DSSCircuits/GeogramONE/EAGLE Files/Geogram ONE.brd

## EAGLE design EAGLE Files/Geogram ONE.brd (2012-09-10)

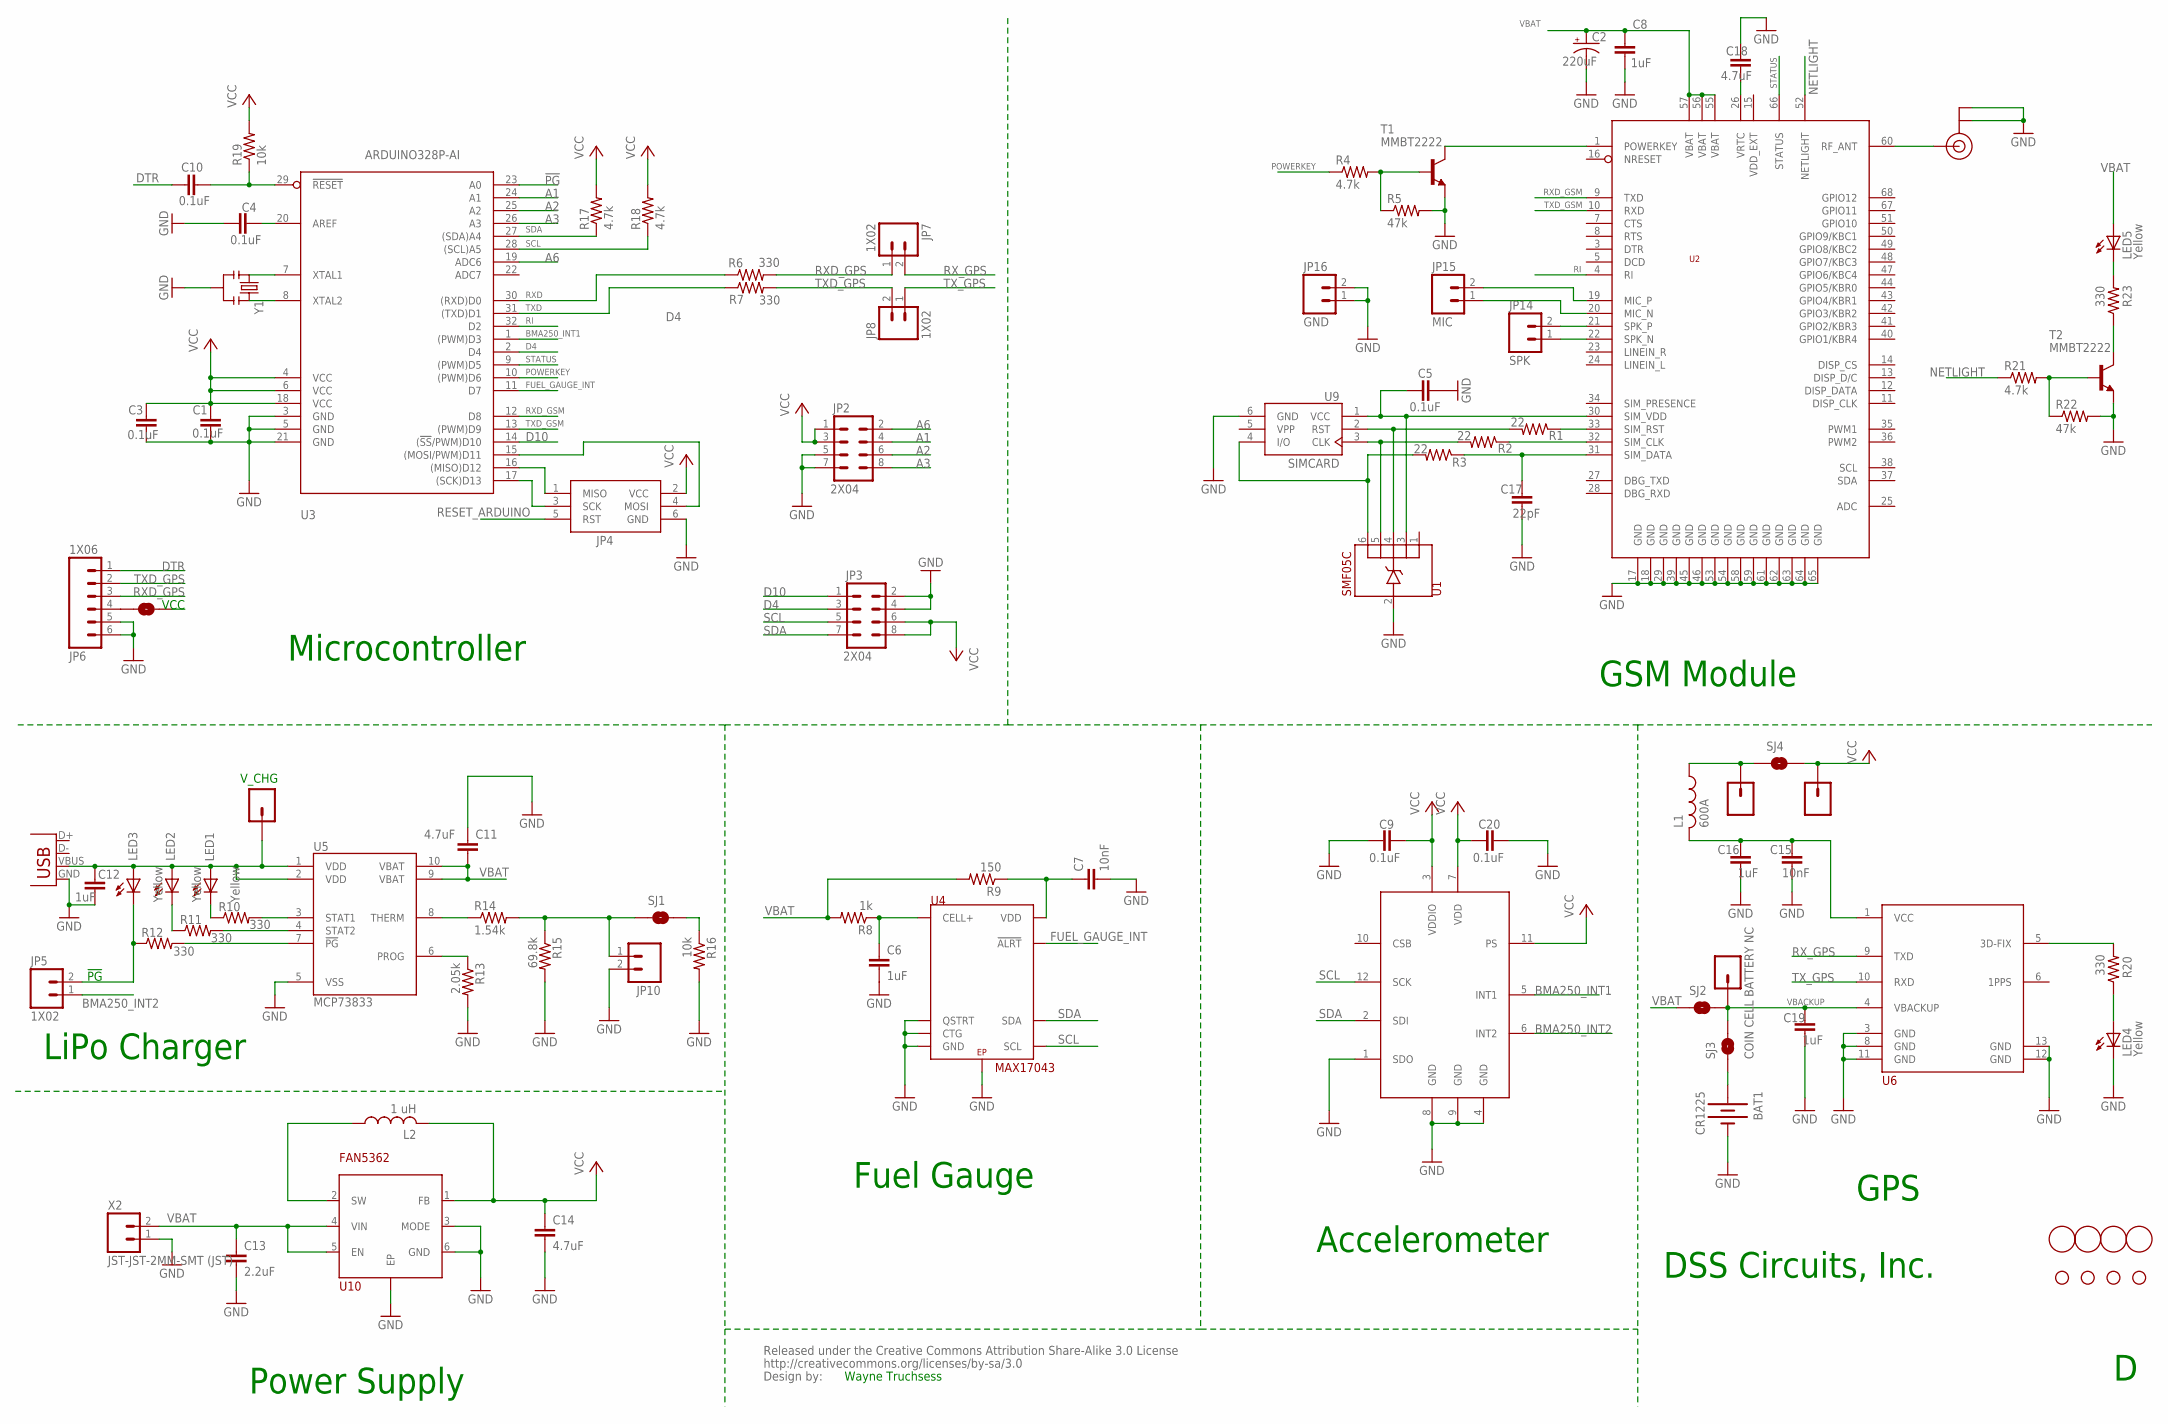
[picture p1: schematic Geogram ONE.sch]

Parts:
BAT1: CR1225; BATTCON_12MM; MOUSER# 534-3000TR; DIGIKEY# 3000KTR-ND
C1, C3, C4, C5, C9, C10, C20: 0.1uF; C0603; MOUSER# 80-C0603C104K8R; DIGIKEY# 399-1095-2-ND
C2: 220uF; D/7343-31R; MOUSER# 80-T520D227M010; DIGIKEY# 399-4045-2-ND
C6, C8, C12, C16, C19: 1uF; C0603; MOUSER# 810-C1608X5R1A105K; DIGIKEY# 445-1321-2-ND
C7, C15: 10nF; C0603; MOUSER# 77-VJ0603Y103KXQCBC
C11, C14, C18: 4.7uF; C0603; MOUSER# 80-C0603C475K9P; DIGIKEY# 399-3482-2-ND
C13: 2.2uF; C0603; MOUSER# 80-C0603C225K9P; DIGIKEY# 399-3362-2-ND
C17: 22pF; C0603; MOUSER# 77-VJ0603A220KXJPBC
FIDUCIAL1, FIDUCIAL2, FIDUCIAL3, FIDUCIAL4: FIDUCIAL; FIDUCIAL_1MM
JP2, JP3: 2X04; 2X4
JP4: AVRISP-6; AVRISP
JP5, JP7, JP8: 1X02; 1X02_NO_SILK
JP6: 1X06
JP9: V_CHG; 1X01
JP10: EXT THERMISTER; 1X02_NO_SILK
JP11: EXT_BAT; 1X01
JP12, JP13: EXT GPS POWER JPR; 1X01
JP14: SPK; 1X02_NO_SILK
JP15: MIC; 1X02_NO_SILK
JP16: GND; 1X02_NO_SILK
L1: 600A; L2012C; MOUSER# 810-MMZ2012R601A
L2: 1 uH; L2012C; MOUSER# 81-LQM21PN1R0MC0D; DIGIKEY# 490-4992-2-ND
LED1, LED2, LED3, LED4, LED5: Yellow; CHIP-LED0603; MOUSER# 720-LYQ971H1K136; DIGIKEY# 475-2557-2-ND
LICENSE: CREATIVE_COMMONS
R1, R2, R3: 22; R0603; MOUSER# 667-ERJ-3EKF22R0V; DIGIKEY# P22.0HTR-ND
R4, R17, R18, R21: 4.7k; R0603; MOUSER# 667-ERJ-3EKF4701V; DIGIKEY# P4.70KHTR-ND
R5, R22: 47k; R0603; MOUSER# 667-ERJ-3EKF4702V; DIGIKEY# P47.0KHTR-ND
R6, R7, R10, R11, R12, R20, R23: 330; R0603; MOUSER# 667-ERJ-3EKF3300V; DIGIKEY# P330HTR-ND
R8: 1k; R0603; MOUSER# 667-ERJ-3EKF1001V; DIGIKEY# P1.00KHTR-ND
R9: 150; R0603; MOUSER# 667-ERJ-3EKF1500V; DIGIKEY# P150HTR-ND
R13: 2.05k; R0603; MOUSER# 667-ERJ-3EKF2051V; DIGIKEY# P2.05KHTR-ND
R14: 1.54k; R0603; MOUSER# 71-CRCW0603-1.54K-E3; DIGIKEY# 541-1.54KHTR-ND
R15: 69.8k; R0603; MOUSER# 667-ERJ-3EKF6982V; DIGIKEY# P69.8KHTR-ND
R16, R19: 10k; R0603; MOUSER# 667-ERJ-3EKF1002V; DIGIKEY# P10.0KHTR-ND
SJ1: EXT THERMISTER NC; SJ_2S-TRACE
SJ2: LIPO BATTERY NO; SJ_2S-NO
SJ3: COIN CELL BATTERY NC; SJ_2S-TRACE
SJ4: EXT GPS POWER NC; SJ_2S-TRACE
SJ5: EXT VCC NO; SJ_2S-NO
STANDOFF1, STANDOFF2, STANDOFF3, STANDOFF4: STAND-OFF
T1, T2: MMBT2222; SOT23-BEC; MOUSER# 512-MMBT2222A; DIGIKEY# MMBT2222AFSTR-ND
U1: SMF05C; SC70-6L; DIGIKEY# SMF05CTR-ND
U2: SIM900
U3: ARDUINO328P-AI; TQFP32-08; MOUSER# 556-ATMEGA328P-AU; DIGIKEY# ATMEGA328P-AU-ND
U4: MAX17043; TDFN8; MOUSER# 700-MAX17043G+T; DIGIKEY# MAX17043G+T-ND
U5: MCP73833; MSOP-10; MOUSER# 579-MCP73833-FCI/UN; DIGIKEY# MCP73833-FCI/UN-ND
U6: PA6C
U7: BMA250; 12LGA_VGG3-D; DIGIKEY# 828-1023-6-ND
U8: U.FL; MOUSER# 960-RECE20279001E01; DIGIKEY# 931-1107-2-ND
U9: SIMCARD; MOUSER# 649-7111S2015X02LF; DIGIKEY# 609-1401-2-ND
U10: FAN5362; UMLP; MOUSER# 512-FAN5362UMP33X; DIGIKEY# FAN5362UMP33X-ND
X1: USBSMD; USB-MINIB; DIGIKEY# ED2992TR-ND
X2: JST-JST-2MM-SMT (JST); JST; DIGIKEY# 455-1749-2-ND
Y1: 8 MHz; RESONATOR-SMD; MOUSER# 81-CSTCE8M00G52Z-R0

Connections:
!PG: JP5.2, LED3.C, R12.1, U3.23 (A0)
A1: JP2.4, U3.24 (A1)
A2: JP2.6, U3.25 (A2)
A3: JP2.8, U3.26 (A3)
A6: JP2.2, U3.19 (ADC6)
AREF: C4.2, U3.20 (AREF)
BMA250_INT1: U3.1 ((PWM)D3), U7.5 (INT1)
BMA250_INT2: JP5.1, U7.6 (INT2)
D4: JP3.3, U3.2 (D4)
D10: JP3.1, U3.14 ((!SS!/PWM)D10)
DTR: C10.1, JP6.1
FUEL_GAUGE_INT: U3.11 (D7), U4.!ALRT
GND: BAT1.GND (-), C1.2, C2.-, C3.2, C4.1, C5.2, C6.2, C7.2, C8.2, C9.2, C11.1, C12.2, C13.2, C14.2, C15.1, C16.1, C17.1, C18.1, C19.1, C20.1, JP2.5, JP2.7, JP3.2, JP3.4, JP4.6 (GND), JP6.5, JP6.6, JP10.2, JP16.1, JP16.2, LED4.C, R5.2, R13.2, R15.2, R16.2, R22.2, T1.E, T2.E, U1.2, U2.17 (GND), U2.18 (GND), U2.29 (GND), U2.39 (GND), U2.45 (GND), U2.46 (GND), U2.53 (GND), U2.54 (GND), U2.58 (GND), U2.59 (GND), U2.61 (GND), U2.62 (GND), U2.63 (GND), U2.64 (GND), U2.65 (GND), U3.3 (GND), U3.5 (GND), U3.21 (GND), U4.CTG, U4.EP, U4.GND, U4.QSTRT, U5.5 (VSS), U6.3 (GND), U6.8 (GND), U6.11 (GND), U6.12 (GND), U6.13 (GND), U7.1 (SDO), U7.4 (GND), U7.8 (GND), U7.9 (GND), U8.P$1 (GND), U8.P$2 (GND), U9.6 (GND), U10.3 (MODE), U10.6 (GND), U10.7 (EP), X1.GND, X2.1, Y1.2
MIC_N: JP15.1, U2.20 (MIC_N)
MIC_P: JP15.2, U2.19 (MIC_P)
MISO: JP4.1 (MISO), U3.16 ((MISO)D12)
MOSI: JP4.4 (MOSI), U3.15 ((MOSI/PWM)D11)
unnamed: C18.2, U2.26 (VRTC)
unnamed: R2.1, U2.32 (SIM_CLK)
unnamed: R20.2, U6.5 (3D-FIX)
unnamed: C6.1, R8.1, U4.CELL+
unnamed: R1.1, U2.33 (SIM_RST)
unnamed: C17.2, R3.1, U2.31 (SIM_DATA)
unnamed: R2.2, U1.5, U9.3 (CLK)
unnamed: R1.2, U1.4, U9.2 (RST)
unnamed: R3.2, U1.6, U9.4 (I/O)
unnamed: LED4.A, R20.1
unnamed: U2.60 (RF_ANT), U8.P$3 (SIGNAL)
unnamed: T1.C, U2.1 (POWERKEY)
unnamed: R4.2, R5.1, T1.B
unnamed: BAT1.PWR@2 (+), SJ3.1
unnamed: R21.2, R22.1, T2.B
unnamed: R23.1, T2.C
unnamed: JP6.4, SJ5.2
unnamed: C7.1, R9.1, U4.VDD
unnamed: LED1.C, R10.1
unnamed: LED2.C, R11.1
unnamed: JP12.1, L1.1, SJ4.1, SJ5.1
unnamed: R13.1, U5.6 (PROG)
unnamed: R14.1, U5.8 (THERM)
unnamed: LED5.C, R23.2
unnamed: JP10.1, R14.2, R15.1, SJ1.1
unnamed: L2.1, U10.2 (SW)
unnamed: R16.1, SJ1.2
NETLIGHT: R21.1, U2.52 (NETLIGHT)
PG: R12.2, U5.7 (!PG)
POWERKEY: R4.1, U3.10 ((PWM)D6)
RESET_ARDUINO: C10.2, JP4.5 (RST), R19.1, U3.29 (!RESET)
RI: U2.4 (RI), U3.32 (D2)
RXD: R6.1, U3.30 ((RXD)D0)
RXD_GPS: JP6.3, JP7.1, R6.2
RXD_GSM: U2.9 (TXD), U3.12 (D8)
RX_GPS: JP7.2, U6.9 (TXD)
SCK: JP4.3 (SCK), U3.17 ((SCK)D13)
SCL: JP3.5, R18.1, U3.28 ((SCL)A5), U4.SCL, U7.12 (SCK)
SDA: JP3.7, R17.1, U3.27 ((SDA)A4), U4.SDA, U7.2 (SDI)
SIM_VDD: C5.1, U1.3, U2.30 (SIM_VDD), U9.1 (VCC)
SPK_N: JP14.1, U2.22 (SPK_N)
SPK_P: JP14.2, U2.21 (SPK_P)
STAT1: R10.2, U5.3 (STAT1)
STAT2: R11.2, U5.4 (STAT2)
STATUS: U2.66 (STATUS), U3.9 ((PWM)D5)
TXD: R7.1, U3.31 ((TXD)D1)
TXD_GPS: JP6.2, JP8.2, R7.2
TXD_GSM: U2.10 (RXD), U3.13 ((PWM)D9)
TX_GPS: JP8.1, U6.10 (RXD)
VBACKUP: C19.2, JP11.1, SJ2.2, SJ3.2, U6.4 (VBACKUP)
VBAT: C2.+, C8.1, C11.2, C13.1, LED5.A, R8.2, R9.2, SJ2.1, U2.55 (VBAT), U2.56 (VBAT), U2.57 (VBAT), U5.9 (VBAT), U5.10 (VBAT), U10.4 (VIN), U10.5 (EN), X2.2
VBUS: C12.1, JP9.1, LED1.A, LED2.A, LED3.A, U5.1 (VDD), U5.2 (VDD), X1.VBUS
VCC: C1.1, C3.1, C9.1, C14.1, C20.2, JP2.1, JP2.3, JP3.6, JP3.8, JP4.2 (VCC), JP13.1, L2.2, R17.2, R18.2, R19.2, SJ4.2, U3.4 (VCC), U3.6 (VCC), U3.18 (VCC), U7.3 (VDDIO), U7.7 (VDD), U7.11 (PS), U10.1 (FB)
VCC_GPS: C15.2, C16.2, L1.2, U6.1 (VCC)
VDD_EXT: U2.15 (VDD_EXT)
VPP: U9.5 (VPP)
XTAL1: U3.7 (XTAL1), Y1.1
XTAL2: U3.8 (XTAL2), Y1.3

Notes on the sheet:
Microcontroller
GSM Module
GPS
Fuel Gauge
Accelerometer
Power Supply
LiPo Charger
V_CHG
DSS Circuits, Inc.
VCC
!PG
Wayne Truchsess

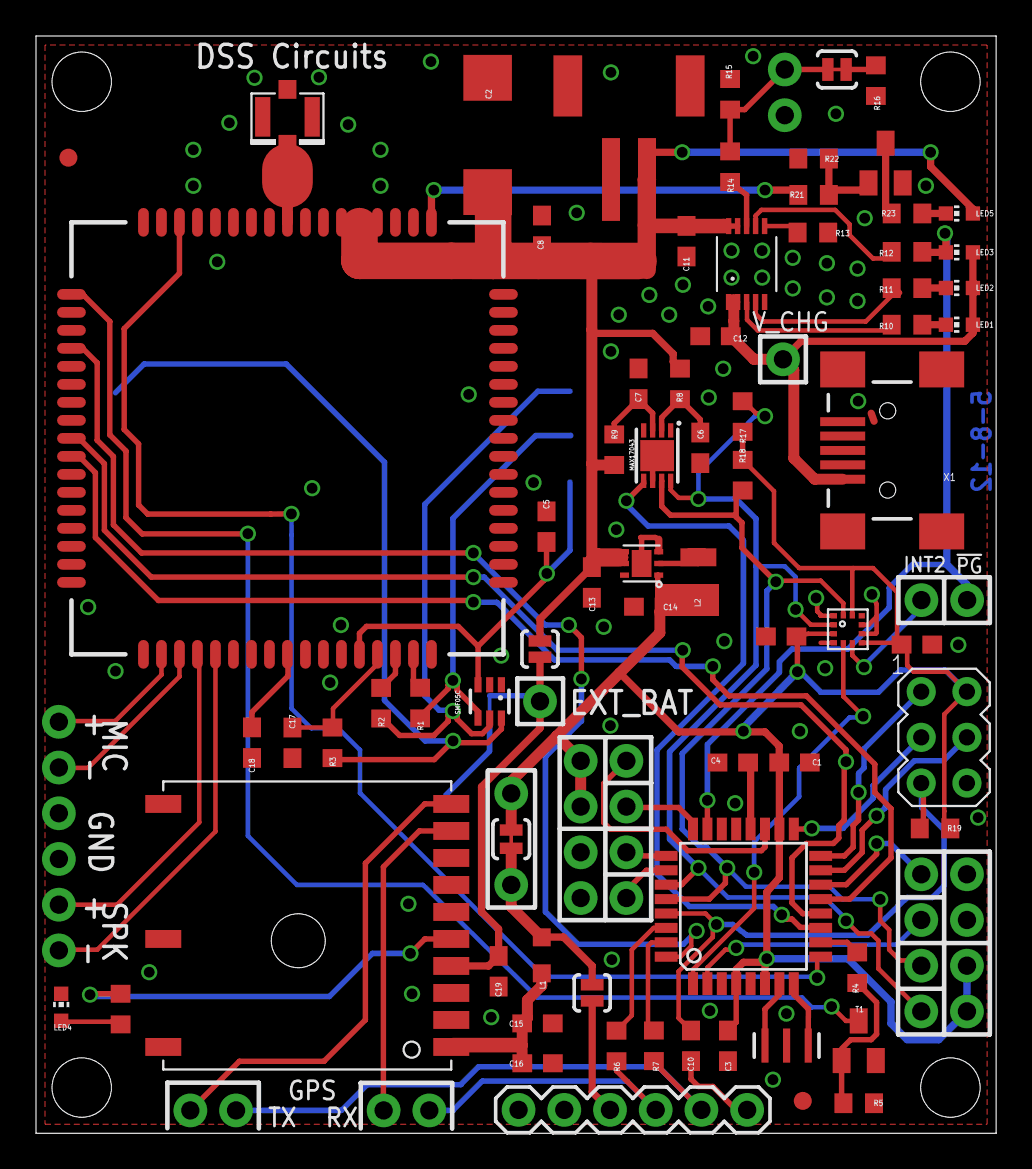
[picture p2: board Geogram ONE.brd from above]

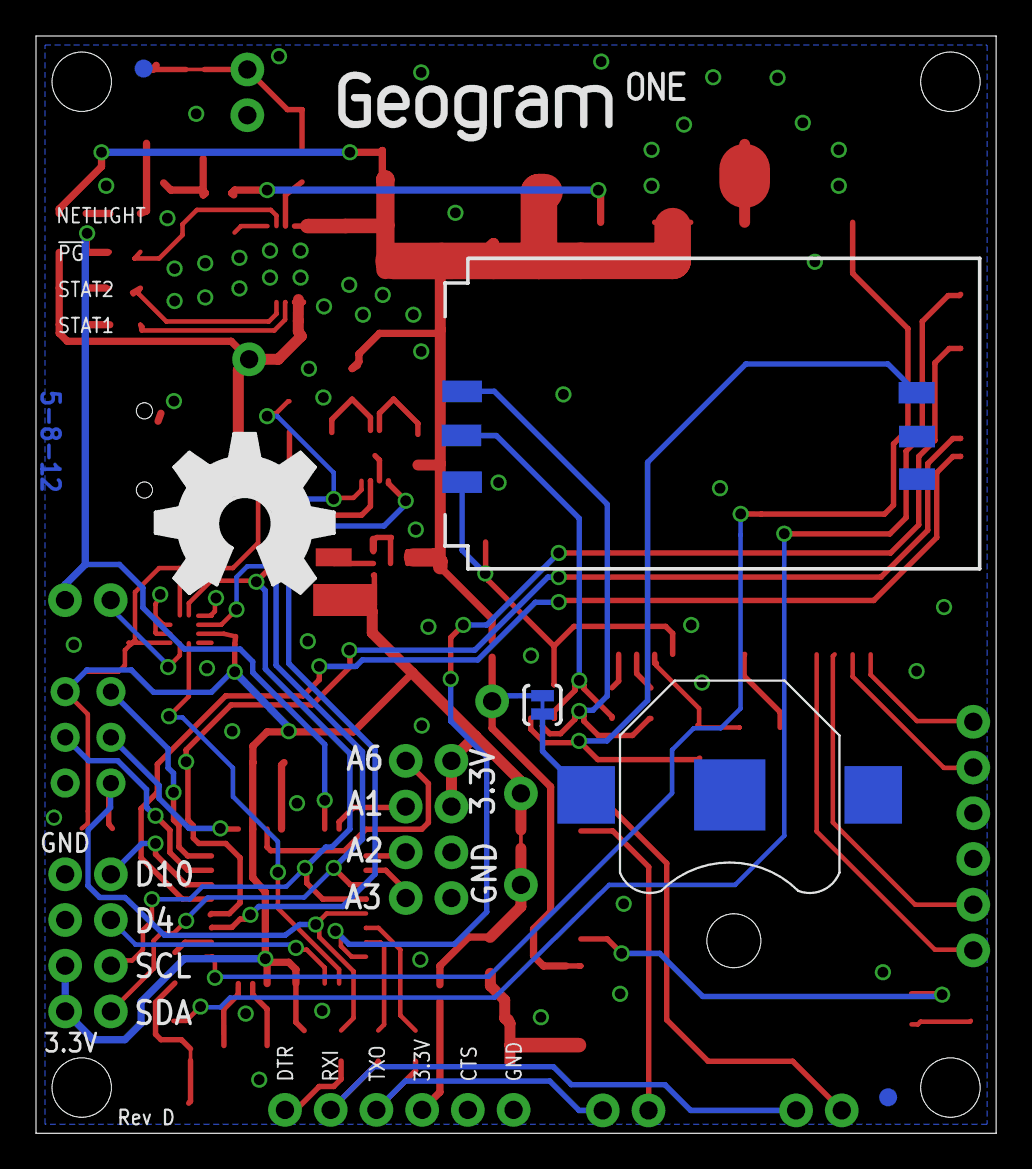
[picture p3: board Geogram ONE.brd from below]

Board: 2 copper layers, 53.3 x 61.0 mm, 97 parts (7 on the bottom side), 73 nets.

Other parts of the board:
U$10: OSHW_FILLX350_NOTEXT
U$11: GEOGRAM_ONE_LOGO
