DSSCircuits/GeogramONE/examples/GeogramONE/GeogramONE.pde

/*****************************************************************************
The Geogram ONE is an open source tracking device/development board based off 
the Arduino platform.  The hardware design and software files are released 
under CC-SA v3 license.
*****************************************************************************/

#include <AltSoftSerial.h>
#include <PinChangeInt.h>
#include "GeogramONE.h"
#include <EEPROM.h>
#include <I2C.h>
#include "eepromAnything.h"

#define USEFENCE1			1  //set to zero to free up code space if option is not needed
#define USEFENCE2			1  //set to zero to free up code space if option is not needed
#define USEFENCE3			1  //set to zero to free up code space if option is not needed
#define USESPEED			1  //set to zero to free up code space if option is not needed
#define USEMOTION			1  //set to zero to free up code space if option is not needed

#define USEPOWERSWITCH		1


GeogramONE ggo;
AltSoftSerial GSM;
SIM900 sim900(&GSM);
geoSmsData smsData;
PA6C gps(&Serial); 
goCoord lastValid;
geoFence fence;


volatile uint8_t call;
volatile uint8_t move;
volatile uint8_t battery = 0;
volatile uint8_t charge = 0x02; // force a read of the charger cable
volatile uint8_t d4Switch = 0x00;
volatile uint8_t d10Switch = 0x00;

#if USEPOWERSWITCH
volatile uint8_t d11PowerSwitch;
#endif

uint8_t cmd0 = 0;
uint8_t cmd1 = 0;
uint8_t cmd3 = 0;
uint8_t udp = 0x00; 

//#if USEFENCE1
uint8_t fence1 = 0;
uint8_t breach1Conf = 0;
//#endif
//#if USEFENCE2
uint8_t fence2 = 0;
uint8_t breach2Conf = 0;
//#endif
//#if USEFENCE3
uint8_t fence3 = 0;
uint8_t breach3Conf = 0;
//#endif

uint8_t breachSpeed = 0;
uint8_t breachReps = 0;

uint32_t smsInterval = 0;
uint32_t udpInterval = 0;
uint32_t sleepTimeOn = 0;
uint32_t sleepTimeOff = 0;
uint8_t sleepTimeConfig = 0;

uint8_t speedHyst = 0;
uint16_t speedLimit = 0;

char udpReply[11];
uint8_t smsPowerProfile = 0;
uint8_t udpPowerProfile = 0;
uint8_t smsPowerSpeed = 0;
uint8_t udpPowerSpeed = 0;

bool gsmPowerStatus = true;

void goesWhere(char *, uint8_t replyOrStored = 0);
bool engMetric;

uint32_t apn;


void setup()
{
	ggo.init();
	gps.init(115200);
	sim900.init();
	MAX17043init(7, 500);
	BMA250init(3, 500);
	attachInterrupt(0, ringIndicator, FALLING);
	attachInterrupt(1, movement, FALLING);
	PCintPort::attachInterrupt(PG_INT, &charger, CHANGE);
	PCintPort::attachInterrupt(FUELGAUGEPIN, &lowBattery, FALLING);
	goesWhere(smsData.smsNumber);
	call = sim900.checkForMessages();
	if(call == 0xFF)
		call = 0;
	battery = MAX17043getAlertFlag();
	EEPROM_readAnything(APN,apn);
	#if USEFENCE1
	ggo.getFenceActive(1, &fence1);
	#endif
	#if USEFENCE2
	ggo.getFenceActive(2, &fence2);
	#endif
	#if USEFENCE3
	ggo.getFenceActive(3, &fence3);
	#endif
	#if USESPEED
	ggo.configureSpeed(&cmd3, &speedHyst, &speedLimit);
	#endif
	ggo.configureBreachParameters(&breachSpeed, &breachReps);
	ggo.configureSleepTime(&sleepTimeOn, &sleepTimeOff, &sleepTimeConfig);
	BMA250enableInterrupts();
	uint8_t swInt = EEPROM.read(IOSTATE0);
	if(swInt == 0x05)
		PCintPort::attachInterrupt(4, &d4Interrupt, RISING);
	if(swInt == 0x06)
		PCintPort::attachInterrupt(4, &d4Interrupt, FALLING);
	swInt = EEPROM.read(IOSTATE1);
	if(swInt == 0x05)
		PCintPort::attachInterrupt(10, &d10Interrupt, RISING);
	if(swInt == 0x06)
		PCintPort::attachInterrupt(10, &d10Interrupt, FALLING);
	#if USEPOWERSWITCH
	pinMode(11,INPUT);
	digitalWrite(11,HIGH);
	PCintPort::attachInterrupt(11, &d11Interrupt, FALLING);
	#endif
}

void loop()
{
	if(!gps.getCoordinates(&lastValid))
	{
		int8_t tZ = EEPROM.read(TIMEZONE);
		bool eM = EEPROM.read(ENGMETRIC);
		gps.updateRegionalSettings(tZ, eM, &lastValid);
		EEPROM_readAnything(APN,apn);
	}
	if(call)
	{
		sim900.gsmSleepMode(0);
		char pwd[5];
		EEPROM_readAnything(PINCODE,pwd);
		if(sim900.signalQuality())
		{
			if(!sim900.getGeo(&smsData, pwd))
			{
				if(!smsData.smsPending)
					call = 0; // no more messages
				if(smsData.smsDataValid)
				{
					if(!smsData.smsCmdNum)
						cmd0 = 0x01;
					else if(smsData.smsCmdNum == 1)
						cmd1 = 0x01;
					else if(smsData.smsCmdNum == 2)
						command2();
					else if(smsData.smsCmdNum == 3)
						cmd3 = 0x01;
					else if(smsData.smsCmdNum == 4)
						command4();
					else if(smsData.smsCmdNum == 5)
						command5();
					else if(smsData.smsCmdNum == 6)
						command6();
					else if(smsData.smsCmdNum == 7)
						command7();
					else if(smsData.smsCmdNum == 8)
						command8();
					else if(smsData.smsCmdNum == 255)
					{
						BMA250configureMotion();
						sim900.gsmSleepMode(0);
						sim900.rebootGSM();
						gsmPowerStatus = true;
					}
				}
			}
		}
		sim900.gsmSleepMode(2);	
	}
	if(cmd0)
		command0();
	#if USEMOTION
	if(cmd1)
		command1();
	#endif
	#if USESPEED
	if(cmd3)
		command3();
	#endif
	if(udp)
	{
		if(lastValid.signalLock && (lastValid.updated & 0x01))
		{
			if((udpInterval > 5))
				sim900.gsmSleepMode(0);
			if(!udpOrange())
			{
				udp = 0;
				lastValid.updated &= ~(0x01);
				if(udpInterval > 5)
					sim900.gsmSleepMode(2);
			}
		}
	}
	
	if(battery)
	{
		sim900.gsmSleepMode(0);
		goesWhere(smsData.smsNumber,1);
		if(!sim900.prepareSMS(smsData.smsNumber,apn))
		{
			printEEPROM(BATTERYMSG);
			if(!sim900.sendSMS())
			{
				battery = 0;
				MAX17043clearAlertFlag();
			}
		}
		sim900.gsmSleepMode(2);
	}
	if(charge & 0x02)
		chargerStatus();
	engMetric = EEPROM.read(ENGMETRIC);
	#if USEFENCE1
	if(fence1)
	{
		if((fence1 == 1) && (lastValid.speed >= breachSpeed))
		{
			ggo.configureFence(1,&fence); 
			if(!gps.geoFenceDistance(&lastValid, &fence, engMetric))
			{
				if(lastValid.updated & 0x02)
					breach1Conf++;
				if(breach1Conf > breachReps)
				{
					fence1 = 2;
					breach1Conf = 0;
				}
				lastValid.updated &= ~(0x02); 
			}
			else
				breach1Conf = 0;
		}
		else
			breach1Conf = 0;
		if(fence1 == 2)
		{
			sim900.gsmSleepMode(0);
			goesWhere(smsData.smsNumber,1);
			if(!sim900.prepareSMS(smsData.smsNumber,apn))
			{
				printEEPROM(FENCE1MSG);
				if(!sim900.sendSMS())
					fence1 = 0x00;
			}
			sim900.gsmSleepMode(2);
		}
	}
	#endif
	#if USEFENCE2
	if(fence2)
	{
		if((fence2 == 1) && (lastValid.speed >= breachSpeed))
		{  
			ggo.configureFence(2,&fence);
			if(!gps.geoFenceDistance(&lastValid, &fence, engMetric))
			{
				if(lastValid.updated & 0x04)
					breach2Conf++;
				if(breach2Conf > breachReps)
				{
					fence2 = 2;
					breach2Conf = 0;
				}
				lastValid.updated &= ~(0x04);
			}
			else
				breach2Conf = 0;
		}
		else
			breach2Conf = 0;
		if(fence2 == 2)
		{  
			sim900.gsmSleepMode(0);
			goesWhere(smsData.smsNumber,1);
			if(!sim900.prepareSMS(smsData.smsNumber,apn))
			{
				printEEPROM(FENCE2MSG);
				if(!sim900.sendSMS())
					fence2 = 0x00;
			}
			sim900.gsmSleepMode(2);
		}
	}
	#endif
	#if USEFENCE3
	if(fence3)
	{
		if((fence3 == 1) && (lastValid.speed >= breachSpeed))
		{  
			ggo.configureFence(3,&fence);
			if(!gps.geoFenceDistance(&lastValid, &fence, engMetric))
			{
				if(lastValid.updated & 0x08)
					breach3Conf++;
				if(breach3Conf > breachReps)
				{
					fence3 = 2;
					breach3Conf = 0;
				}
				lastValid.updated &= ~(0x08);
			}
			else
				breach3Conf = 0;
		}
		else
			breach3Conf = 0;
		if(fence3 == 2)
		{  
			sim900.gsmSleepMode(0);
			goesWhere(smsData.smsNumber,1);
			if(!sim900.prepareSMS(smsData.smsNumber,apn))
			{
				printEEPROM(FENCE3MSG);
				if(!sim900.sendSMS())
					fence3 = 0x00;
			}	
			sim900.gsmSleepMode(2);
		}
	}
	#endif
	if(smsInterval)
		smsTimerMenu();
	if(udpInterval)
		udpTimerMenu();
	if(sleepTimeOn && (sleepTimeOff || (sleepTimeConfig & 0x08)))
		sleepTimer();
	if(d4Switch)
	{
		sim900.gsmSleepMode(0);
		goesWhere(smsData.smsNumber,1);
		if(!sim900.prepareSMS(smsData.smsNumber,apn))
		{
			printEEPROM(D4MSG);
			if(!sim900.sendSMS())
				d4Switch = 0x00;
		}
		sim900.gsmSleepMode(2);
	}
	if(d10Switch)
	{
		sim900.gsmSleepMode(0);
		goesWhere(smsData.smsNumber,1);
		if(!sim900.prepareSMS(smsData.smsNumber,apn))
		{
			printEEPROM(D10MSG);
			if(!sim900.sendSMS())
				d10Switch = 0x00;
		}
		sim900.gsmSleepMode(2);
	}
	#if USEPOWERSWITCH
	if(d11PowerSwitch)
		onOffSwitch();
	#endif
	if(gsmPowerStatus)
		sim900.initializeGSM();
} 

void printEEPROM(uint16_t eAddress)
{
	char eepChar;
	for (uint8_t ep = 0; ep < 50; ep++)
	{
		eepChar = EEPROM.read(ep + eAddress);
		if(eepChar == '\0')
			break;
		else
			GSM.print(eepChar);
	}
}

void goesWhere(char *smsAddress, uint8_t replyOrStored)
{
	if(replyOrStored == 3) 
		EEPROM_readAnything(RETURNADDCONFIG,replyOrStored);
	if((replyOrStored == 1))
		for(uint8_t l = 0; l < 39; l++)
		{
				smsAddress[l] = EEPROM.read(l + SMSADDRESS);
				if(smsAddress[l] == NULL)
					break;
		}
}


#if USEPOWERSWITCH
void onOffSwitch()
{
	delay(3000);
	if(digitalRead(11))
	{
		d11PowerSwitch = 0;
		return;
	}
	BMA250sleepMode(0x80);
	MAX17043sleep(false);
	sim900.powerDownGSM();
	gps.sleepGPS();
	BMA250disableInterrupts();
	ggo.goToSleep(SLEEP_MODE_PWR_DOWN, false, true);
	while(1)
	{
		delay(3000);
		if(!digitalRead(11))
			break;
		ggo.goToSleep(SLEEP_MODE_PWR_DOWN, false, true);
	}
	MAX17043sleep(true);
	BMA250sleepMode(0x00);
	BMA250enableInterrupts();
	gps.wakeUpGPS();
	sim900.initializeGSM();
	gsmPowerStatus = true;
	d11PowerSwitch = 0;
}

#endif
