DSSCircuits/GeogramONE/examples/GeogramONE/Interrupts.pde

void ringIndicator()
{
	call = 1;
}

void movement()
{
	move = 0x0F;
}

void charger()
{
	charge |= 0x02;
}

void lowBattery()
{
	battery = 1;
}

/*************************************************************	
	Procedure to check the status of the USB charging cable. 
	If the charging cable is plugged in  charge variable 
	will be a 0x01.  Unplugged, charge variable is 0x00.

**************************************************************/
void chargerStatus()
{
	delay(2);
	charge = digitalRead(PG_INT);
	smsPowerProfile = EEPROM.read(SMSPOWERPROFILE);
	udpPowerProfile = EEPROM.read(UDPPOWERPROFILE);
	if(charge)
	{
		smsInterval = EEPROM.read(SMSSENDINTERVALPLUG);
		udpInterval = EEPROM.read(UDPSENDINTERVALPLUG);
		smsPowerSpeed = EEPROM.read(SMSSPEEDPLUG);
		udpPowerSpeed = EEPROM.read(UDPSPEEDPLUG);
	}
	else
	{
		smsPowerProfile >>= 4;
		udpPowerProfile >>= 4;
		smsInterval = EEPROM.read(SMSSENDINTERVALBAT);
		udpInterval = EEPROM.read(UDPSENDINTERVALBAT);
		smsPowerSpeed = EEPROM.read(SMSSPEEDBAT);
		udpPowerSpeed = EEPROM.read(UDPSPEEDBAT);
	}
}

void d4Interrupt()
{
	d4Switch = 0x01;
}

void d10Interrupt()
{
	d10Switch = 0x01;
}

#if USEPOWERSWITCH
void d11Interrupt()
{
	d11PowerSwitch = 0x01;
}
#endif
