DSSCircuits/GeogramONE/(commit log)

2012-09-10 Fixed PositionFixIndicator reference. Modified algorithms for geofences
    [GeogramONE.pde, PA6C.cpp, PA6C.h]
2012-09-10 Added beta release of EEPROM Map (unfinished) Converting #define configuration constants to EEPROM settings
    [Geogram ONE EEPROM Map.xlsx]
2012-09-14 removed references to EEPROM removed interrupt specific functions and switched to generic functions
2012-09-14 added more EEPROM settings
    [Geogram ONE EEPROM Map.xlsx]
2012-10-01 Updated address map
    [Geogram ONE EEPROM Map.xlsx]
2012-10-01 - Fixed analogRead addressing - Updates to sleep configuration - Updates to fence configuration
    [GeogramONE.cpp]
2012-10-01 - Added sleepmode function call to power down function call
2012-10-01 - Added option to leave motion interrupts enables if sleep config enabled
2012-10-01 - rewrite of sleep timer function
2012-10-01 - Updated charger status algorithm
2012-10-01 - Updated global variables - Updated geofence calculations - Updated sleep timer calculations
2012-10-15 - Added interrupt routines for D4 and D10 pin change interrupts
2012-10-15 - Added support for pin change interrupts
2012-10-15 - New EEPROM map
    [Geogram ONE EEPROM Map.xlsx]
2012-10-19 - fixed but in longitude and latitude calculation
    [SIM900.cpp]
2012-11-11 -fixed bug affecting operation in positive (UTC +) timezones
    [SIM900.cpp, SIM900.h]
2012-11-16 - Fixed bug associated with latitude and/or longitude readings being off when degrees was less than zero
    - Changed BYTE declaration in SIM900.cpp to char to allow compilation in Arduino 1.0 and above
    [Geogram ONE EEPROM Map.xlsx]
2012-12-13 Fixed bug with battery voltage being reported incorrectly
    [command0.pde]
2012-12-13 Removed debugging print statements that were left in
2013-01-13 another update and it's not working
    [GeogramONE.pde, SIM900.cpp, SIM900.h]
2013-04-14 more changes, this setup works but need to get rid of all the errors and streamline the process more.
    [Interval.pde]
2013-05-07 - fixed issue with smspending
    [GeogramONE.pde, SIM900.cpp, SIM900.h, command0.pde]
2013-05-09 - works. Getting ready to rewrite PA6C library to use character arrays instead of longs and floats
    [Geogram ONE EEPROM Map.xlsx]
2013-06-05 updated map
    [Geogram ONE EEPROM Map.xlsx]
2013-06-06 changed BYTE reference to char to make compatible with Arduino 1.0 and above.
2013-06-07 added ELSE statement to recover from error during CIPSEND
    [UDP_Orange.pde]
2013-06-09 - fixed BYTE references in EEPROM files to support compiling in Arduino 1.0 and above
2013-06-09 - fixed another BYTE reference for Arduino 1.0 compatibility
    [GeogramONE.cpp]
2013-06-13 - added option to check for gsm signal before trying to attach to GPRS service
2013-06-14 - added option to reboot GSM module every 5 minutes if GPRS connection can not be reattached. According to documentation, in worst case scenario a reboot may be necessary.
    [UDP_Orange.pde]
2013-06-15 - added Option 255 which is used to reboot GSM module remotely - added 2 second delay after GSM power down in UDP recovery because of inconsistency issues powering back on
    [GeogramONE.pde, UDP_Orange.pde]
2013-07-05 -changed udp function to uint8_t from void and moved some parameters to the main loop.
    [Geogram ONE EEPROM Map.xlsx]
2013-07-08 - added a flag for monitoring the GSM power status
2013-07-08 - added functionality for send intervals for sms and udp based off charger, motion and speed status
2013-07-08 - added functionality for send intervals for sms and udp based off charger, motion and speed status - added support to poll the GSM at the end of each loop to verify device is still powered on. If it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
2013-07-08 - added functionality for send intervals for sms and udp based off charger, motion and speed status - accelerometer interrupts will be enabled all the time now.
2013-07-12 - Added support for different power profiles for send intervals with SMS and UDP. You can set different intervals for plugged in/charging and on battery. You can also program overrides for profile wi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
    - Fixed bug with Geofences
    - Updated EEPROM map to reflect new settings. If using this version you will need to reprogram the EEPROM also
    - Upda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
    [Geogram ONE EEPROM Map.xlsx]
2013-07-13 - beta testing a new functionality for those encasing the GO's and looking for a way to power it on and off. First enable the power switch by setting #define USEPOWERSWITCH to a 1. Next connect a pus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
2014-07-20 added support for sending emails along with SMS added function to get IMEI number using AT commands added function to reboot GSM changed smsCmdString from 30 to 70 to fix bug with certain incoming sm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
    [SIM900.cpp, SIM900.h]
2014-07-20 included #define for APN in email support feature modified sleep function by adding passed parameters to choose sleepmode, give the option to backup the pin change interrupt register and disable AltS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
2014-07-20 modified EEPROM map to reflect changes in functionality
    [Geogram ONE EEPROM Map.xlsx]
2014-07-20 include #define APN for email support changed default PINCODE to 0000 changed default GeoID to display firmware version changed default http2 from "+(" to " (" due to problem with updates in Google M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
    [GO_V1_1_EEPROM_Program.pde]
2014-07-20 code cleanup to include GSM reboot function added code to automatically populate the IMEI EEPROM field if IMEI[0] contains a space enabled ability to send number of satellites used in UDP string
    [UDP_Orange.pde]
2014-07-20 enabled use of USEPOWERSWITCH for pin D11 included support for email functionality included function call to reconfigure accelerometer motion settings. Can be used when tweaking accelerometer sensiti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
2014-07-20 added new functionality for Power on Tracking Only. PoTO is enabled when bit 3 is true in sleepTimeConfig. changed the call from init to initializeGSM on wake up
2014-07-20 included ability to put MAX17043 in sleep mode to reduce power consumption included ability to put accelerometer in sleep mode to reduce power consumption changed the option to only send message to a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
2014-07-20 added variable to APN to list changed terminating delimiting character to a colon from period to fix problems when certain fields required the use of a period being stored. See exceptions below: exce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
    [command6.pde]
2014-07-20 code change to reflect changes to goesWhere to keep outgoing message sent to address configuration stored in EEPROM added ability to pulse the pin for a programmable amount of time
